partywagon112/EEE20003-Integrated-Lab-Equipment/README.md

# EEE20003-Integrated-Lab-Equipment
A compilation of the designs used in the SMT revision of the laboratory equpiment designed for EEE20003.

Designed by Jordan Boekel, Ben Gregg, and Patrick Curtain.
