partywagon112/EEE20003-Integrated-Lab-Equipment/Management/Minutes/Meeting minutes week 2.docx

# Meeting minutes

Laid out goals for the project

Discussed with project supervisor

Current plans

- Power supply implementation (5V in, 3.3V out)
- Prioritize Traffic lights, Clock, Switch module
- If possible, implement other modules
- Optimize for lower costs, manufacturability – Surface mount, common parts, built in China
