partywagon112/EEE20003-Integrated-Lab-Equipment/Management/Minutes/Meeting Minutes Week 4.docx

Submitted proposal.

Not coding

Serial buffers for low speed outputs.

Hardware debouncing is a bit crap, very large.

Patrick suggests a second micro for debouncing if necessary.

Considered the use of I2C port expanders to handle numerous inputs on a single microprocessor.
