partywagon112/EEE20003-Integrated-Lab-Equipment/PCB/Fabrication/REV0-1/bom.xls

Comment | Description | Designator | Footprint | LibRef | Quantity
1k |  | R7, R8, R9, R10, R11, R12, R13, R18, R27, R30, R31, R34, R39, R40, R41, R42, R43, R44, R45, R46, R55, R56, R57, R58, R59, R60, R61, R62, R68, R71 | 805 | RC0805FR071KL | 30
1uF |  | C1, C3, C7, C8 | 805 | GCM21BR71A105KA37L | 4
4.7uF |  | C2 | 805 | GCM21BR61A475KA37L | 1
5.1k |  | R20, R22 | 805 | RC0805FR075K1L | 2
10k |  | R1, R2, R3, R4, R5, R6, R14, R15, R16, R17, R35, R36, R37, R38, R47, R48, R49, R50, R51, R52, R53, R54 | 805 | RC0805FR0710KL | 22
10nF |  | C9 | 805 | GCM21BR71H103KA37L | 1
22pF |  | C4, C5 | 805 | GCM21B5C1H220JA37L | 2
100nF |  | C6 | 805 | GCM21BR71E104KA37L | 1
100R |  | R21, R69, R70, R72, R73, R74, R75, R76 | 805 | RC0805FR07100RL | 8
200R |  | R19 | 805 | RC0805FR07200RL | 1
330R |  | R23, R24, R25, R26, R67 | 805 | RC0805FR07330RL | 5
680R |  | R28, R29, R32, R33, R63, R64, R65, R66 | 805 | RC0805FR07680RL | 8
LED | Red LED Indication - Discrete 1.75V 0805 (2012 Metric) | D45 | 0805 LED | SML-210LTT86 | 1
Red | Green LED Indication - Discrete 1.75V 0805 (2012 Metric) | D11, D12, D15, D16 | 0805 LED | SML-210FTT86 | 4
Red | Orange LED Indication - Discrete 1.75V 0805 (2012 Metric) | D10, D14 | 0805 LED | SML-211DTT86 | 2
Red | Red LED Indication - Discrete 1.75V 0805 (2012 Metric) | ACTIVE1, D1, D2, D3, D4, D5, D6, D7, D9, D13, D17, D18, D19, D20, D21, D22, D23, D24, D25, D26, D27, D28, D29, D30, D31, D32, D33, D34, D35, D36, D37, D38, D39, D40, D41, D42, D43, D44 | 0805 LED | SML-210LTT86 | 38
0ZCF0100AF2A | PTC RESET FUSE 60V 1A 292 | F1 | 2920 | 0ZCF0100AF2A | 1
 |  | X1 | Abracon HC-49/US | ABLS-16.000MHZ-B4-T | 1
ATMEGA 328P-AU | AVR AVR® ATmega Microcontroller IC 8-Bit 20MHz 32KB (16K x 16) FLASH 32-TQFP (7x7) | BRUCE SPRINGSTEEN1 | ATMEL TQFP-32 | ATMEGA 328P-AU | 1
2.54mm |  | FREQUENCY1, POWER 1, POWER 2 | Header 2x2 | Header 2x2 | 3
2.54mm |  | ICSP1 | Header 2x3 | Header 2x3 | 1
2.54mm |  | P1, STEPPER INPUT1, TRAFFIC INPUT1, TRAFFIC OUTPUT1 | Header 2x4 | Header 2x4 | 4
Header 2x8 |  | FUN BUTTON OUTPUT1, FUN BUTTON OUTPUT2, LIGHTS INPUT1 | Header 2x8 | Header 2x8 | 3
SSD1306 | AU 0.91" IIC I2C OLED LCD Display Module 128x32 for Arduino PIC SSD1306 3.3V~5V | U3 | IIC 128x32 OLED | SSD1306 | 1
SS0823 | SPDT Switch | K16 | Jaycar 2.54 SPDT Slide | SS0823 | 1
MCP23017 | IC I/O EXPANDER I2C 16B 28SOIC | TRAFFIC EXPANDER1, U6 | Microchip 28-SOIC | MCP23017 | 2
RS3236-3.3 | Low Power, Low Dropout, 500mA RF LinearRegulators | U4 | Runic SOT-23-5 | RS3236-3.3 | 1
S16C03-8TR | PD 300W VWM 3.3VCJ 425PFPACKAGE | U2, U5, U8 | SMC 16-SOIC | S16C03-8TR | 3
SN74HC540DWR | IC BUFFER INVERT 6V 20SOIC | U1, U7 | TI 20-SOIC | SN74HC540DWR | 2
USB4085-GF-A | USB - C (Type - C) USB 2.0 Receptacle Connector 16 Position Through Hole, Right Angle | USB1 | USB4085-GF-A | USB4085-GF-A | 1
TS-1187A-C-D-B | TACTILE SWITCHES SPST 5.10MM X 5.10MM 0.80MM SMD ROHS | K1, K2, K3, K4, K5, K6, K7, K8, K9, K10, K11, K12, K13, K14, K15 | XKB SW-4.5 | TS-1187A-C-D-B | 15
