partywagon112/EEE20003-Integrated-Lab-Equipment/PCB/Prints/Bottom Layer-1.png

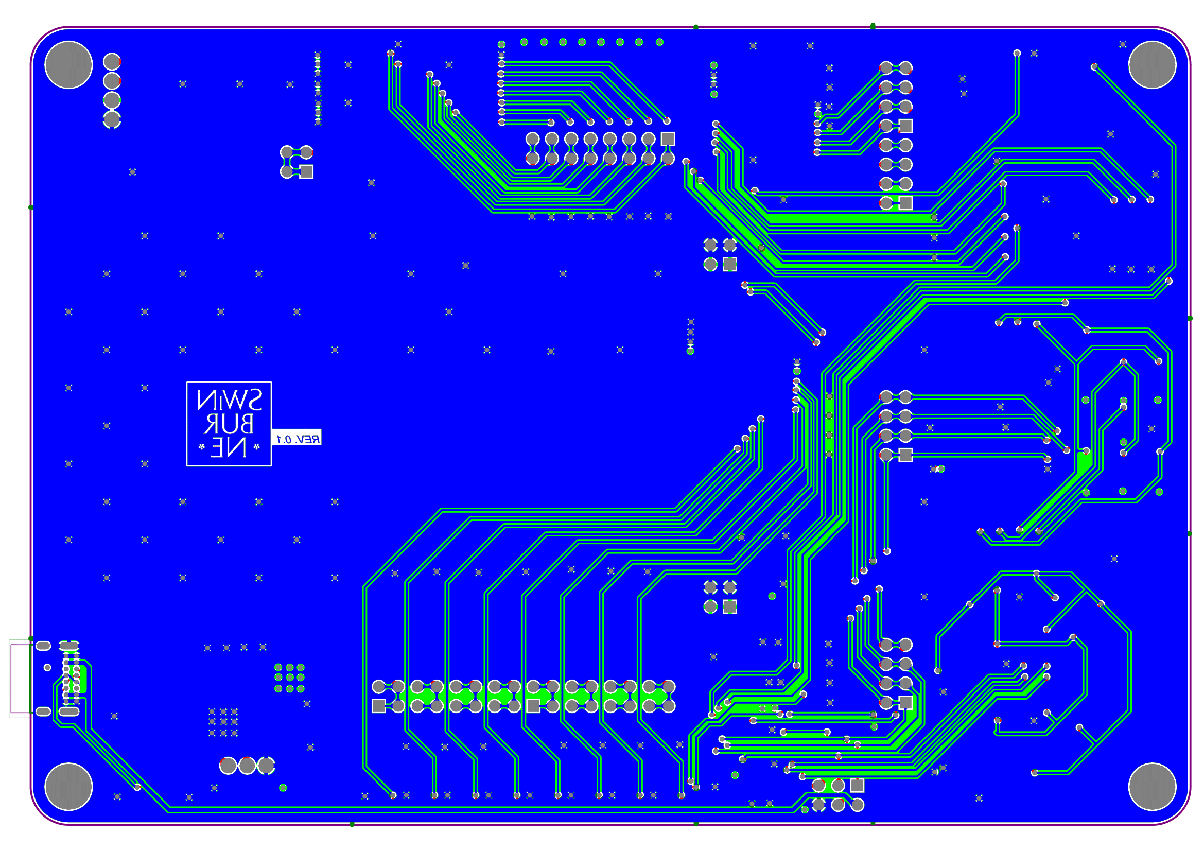
PCB/Prints/Bottom Layer-1.png
