partywagon112/EEE20003-Integrated-Lab-Equipment/PCB/Prints/EEE20001 Lab Equipment-04.png

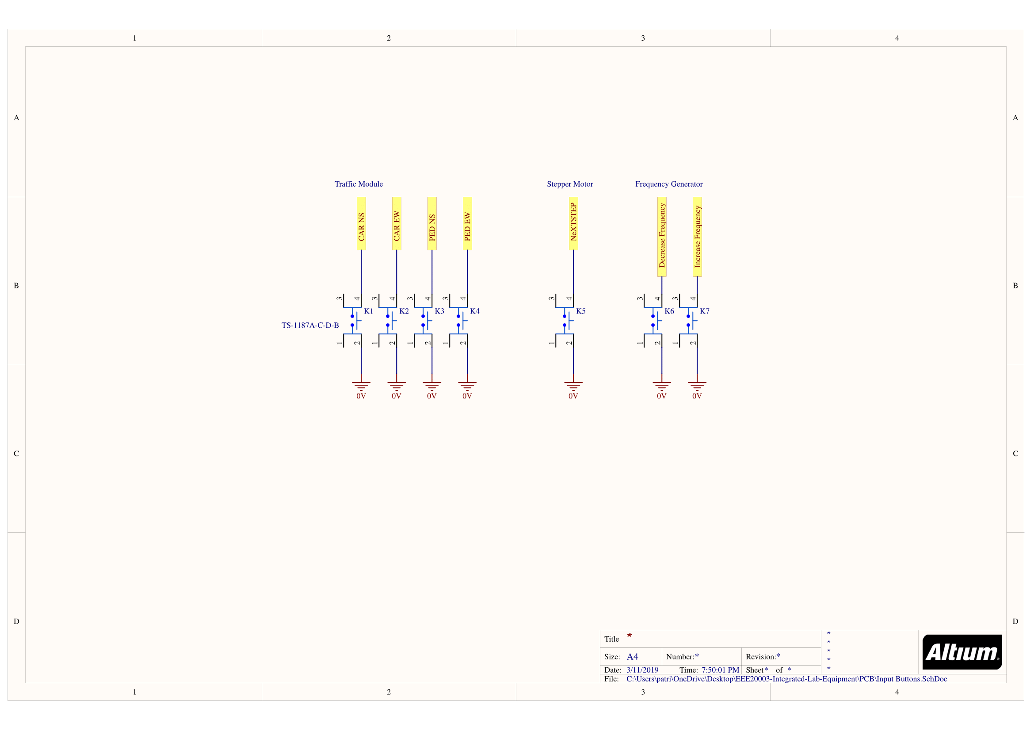
PCB/Prints/EEE20001 Lab Equipment-04.png
