partywagon112/EEE20003-Integrated-Lab-Equipment/PCB/Prints/EEE20001 Lab Equipment.pdf

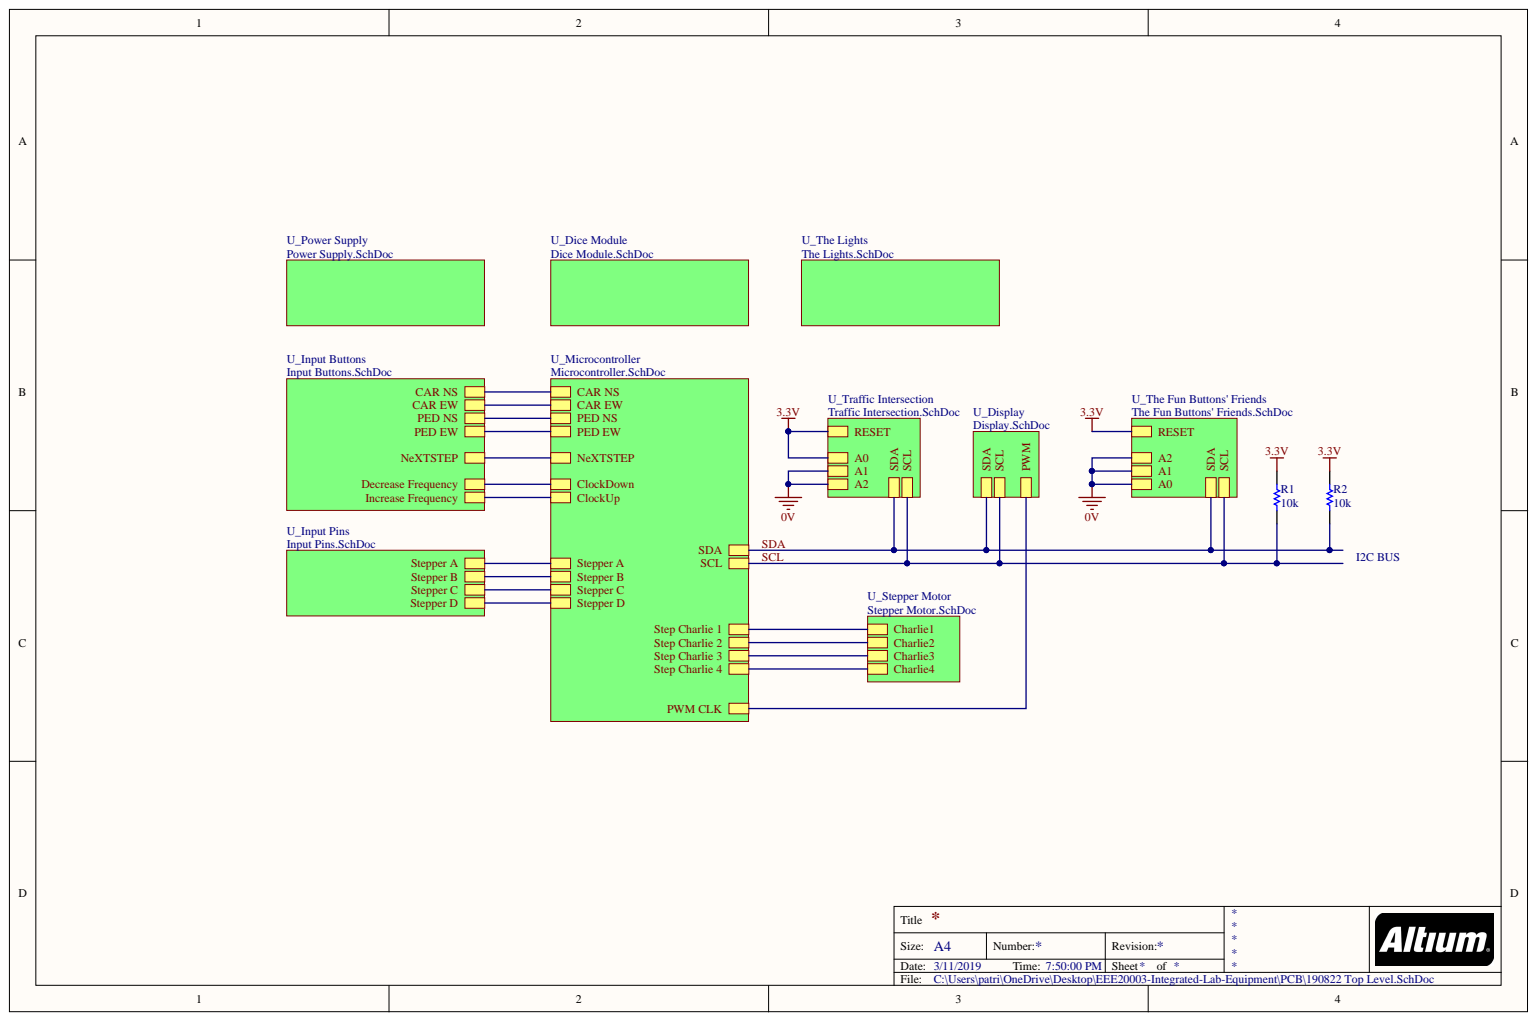
[picture p13: page 1]

RESET SDA

U_Stepper Motor Stepper Motor.SchDoc

* Title | ****

Size: A4 | Number: * | Revision: *
Date: 3/11/2019 Time: 7:50:00 PM | | Sheet * of

C:\Users\patri\OneDrive\Desktop\EEE20003-Integrated-Lab-Equipment\PCB\190822 Top Level.SchDoc

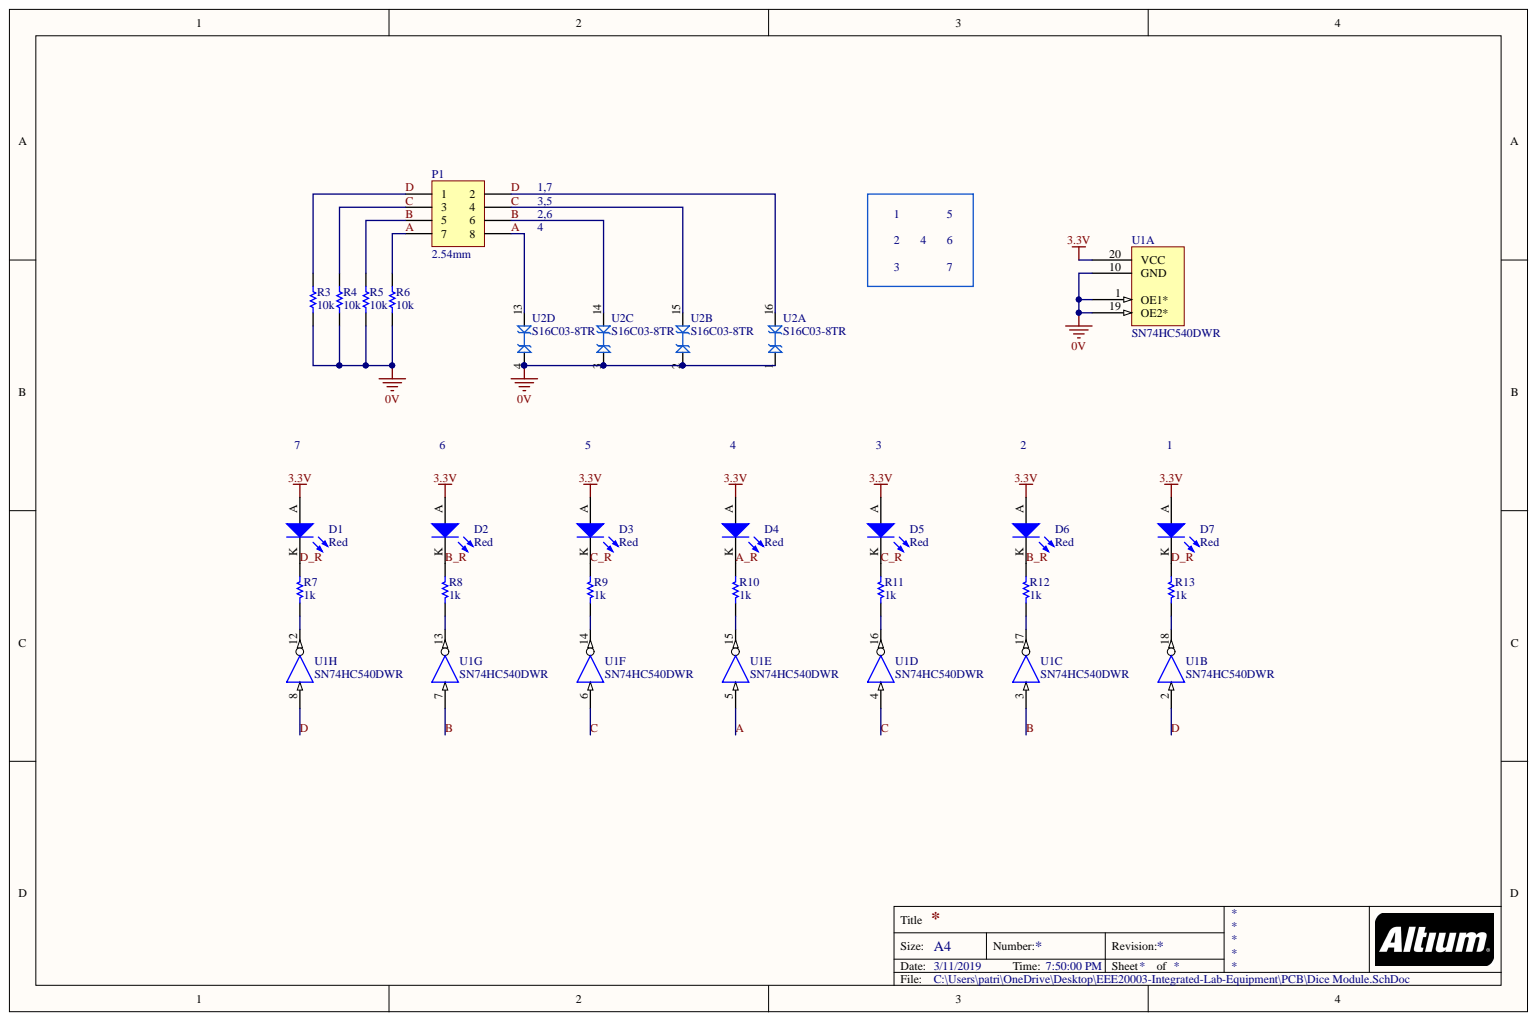
[picture p14: page 2]

B | B 2,6
A | A 4

* Title | * * * * *

Size: A4 | Number: * | Revision: *

C:\Users\patri\OneDrive\Desktop\EEE20003-Integrated-Lab-Equipment\PCB\Dice Module.SchDoc

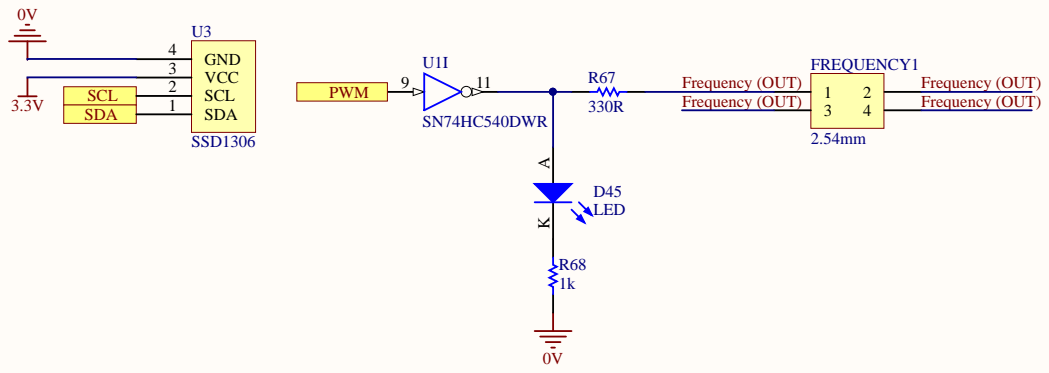
[picture p15: page 3]

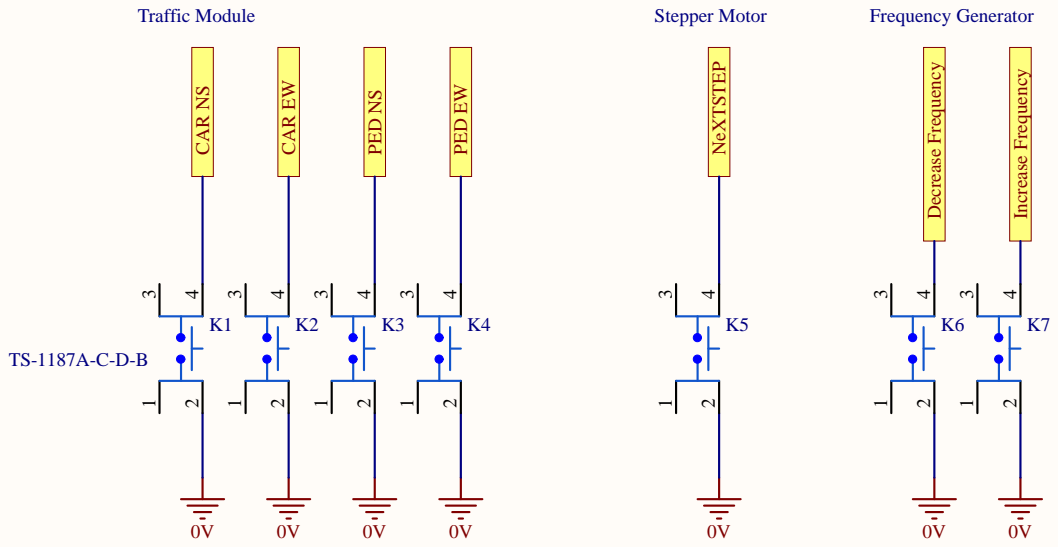
[picture p16: page 4]

* Title | ****

Size: A4 | Number: * | Revision: *

C:\Users\patri\OneDrive\Desktop\EEE20003-Integrated-Lab-Equipment\PCB\Input Buttons.SchDoc

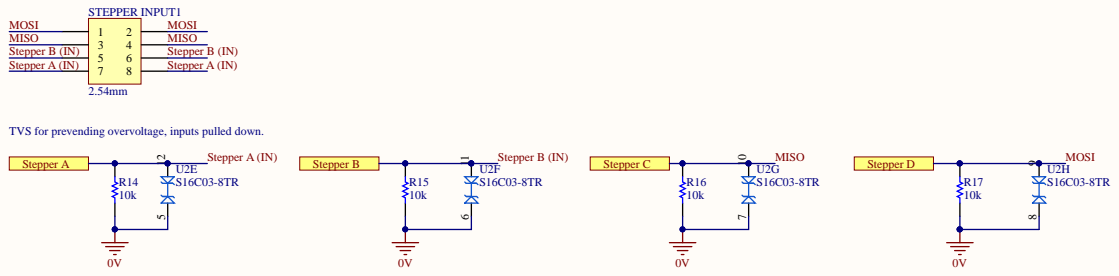
[picture p17: page 5]

TVS for prevending overvoltage, inputs pulled down.

* Title | * *

Size: A4 | Number: * | Revision: *

C:\Users\patri\OneDrive\Desktop\EEE20003-Integrated-Lab-Equipment\PCB\Input Pins.SchDoc

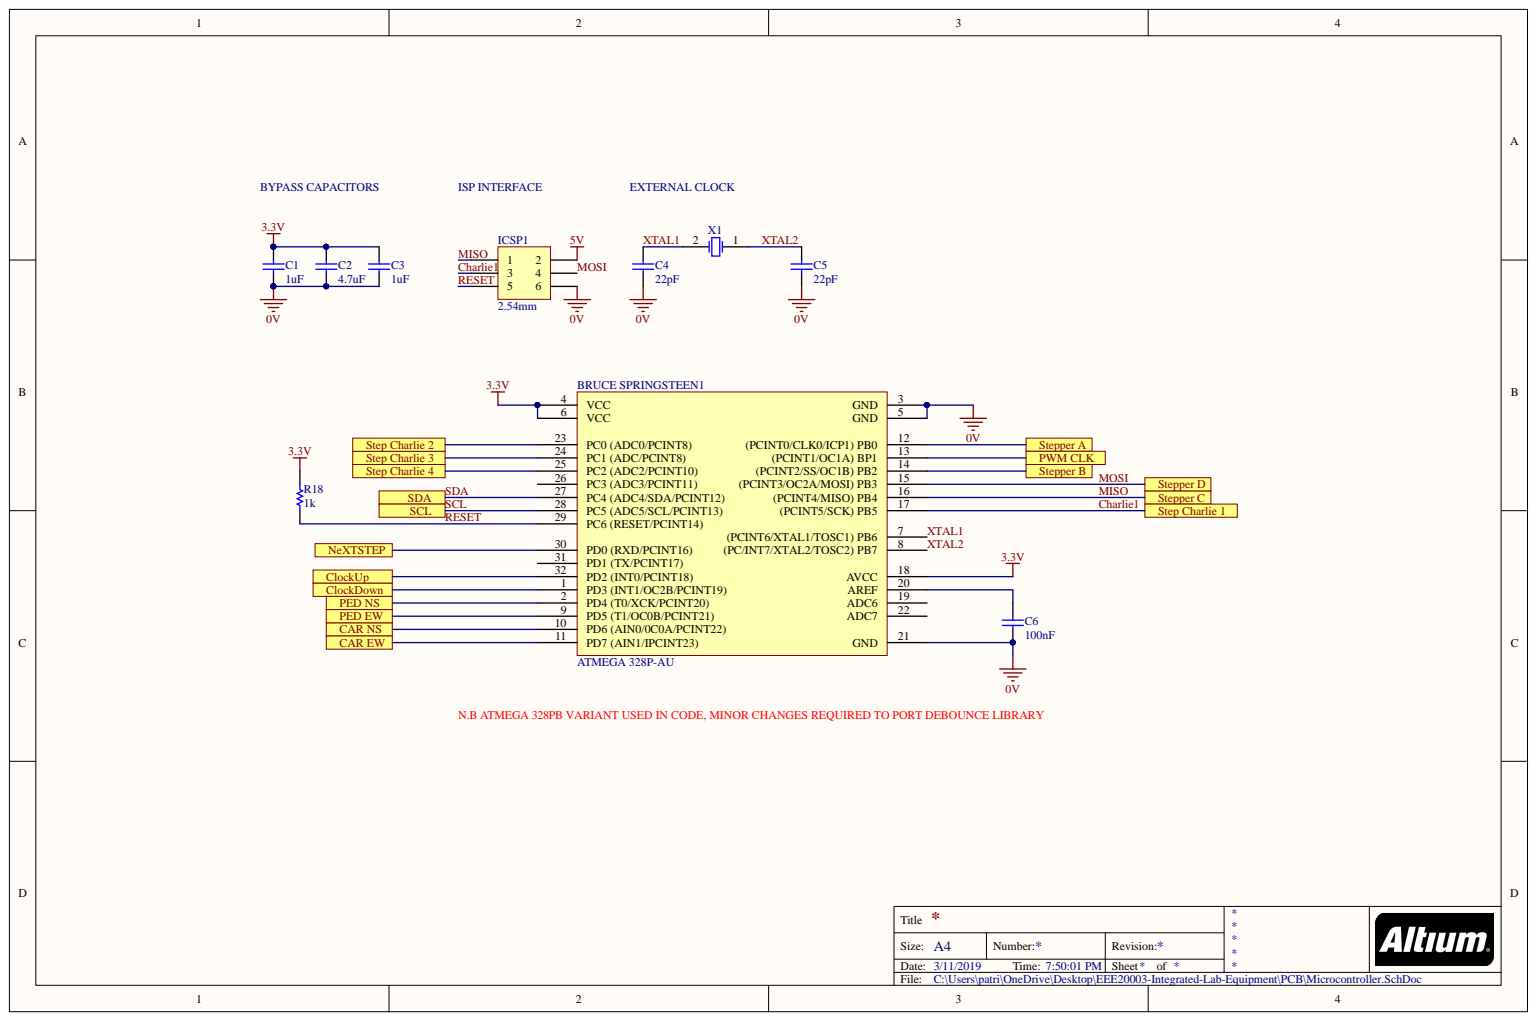
[picture p18: page 6]

SCL | PC5 (ADC5/SCL/PCINT13) 28 | Charlie1

SCL | Step Charlie 1

N.B ATMEGA 328PB VARIANT USED IN CODE, MINOR CHANGES REQUIRED TO PORT DEBOUNCE LIBRARY

* Title | * *

Size: A4 | Number: * | Revision: *

C:\Users\patri\OneDrive\Desktop\EEE20003-Integrated-Lab-Equipment\PCB\Microcontroller.SchDoc

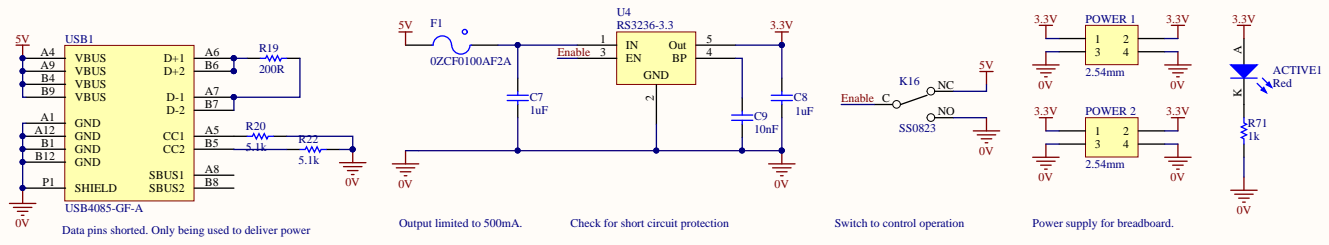
[picture p19: page 7]

Data pins shorted. Only being used to deliver power

* Title | ****

Size: A4 | Number: * | Revision: *

C:\Users\patri\OneDrive\Desktop\EEE20003-Integrated-Lab-Equipment\PCB\Power Supply.SchDoc

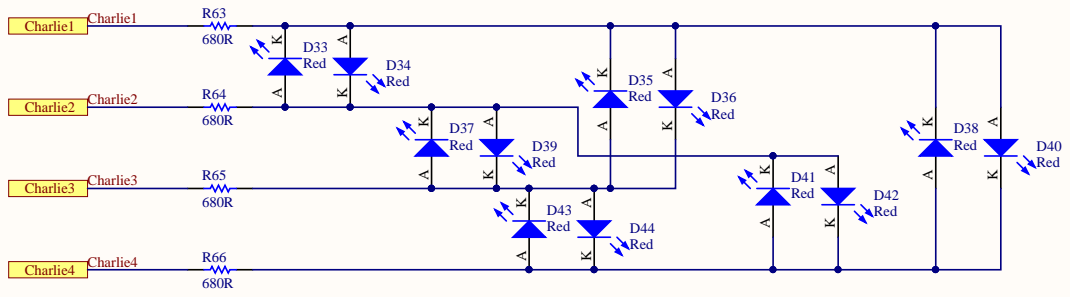
[picture p20: page 8]

* Title | ****

Size: A4 | Number: * | Revision: *

C:\Users\patri\OneDrive\Desktop\EEE20003-Integrated-Lab-Equipment\PCB\Stepper Motor.SchDoc

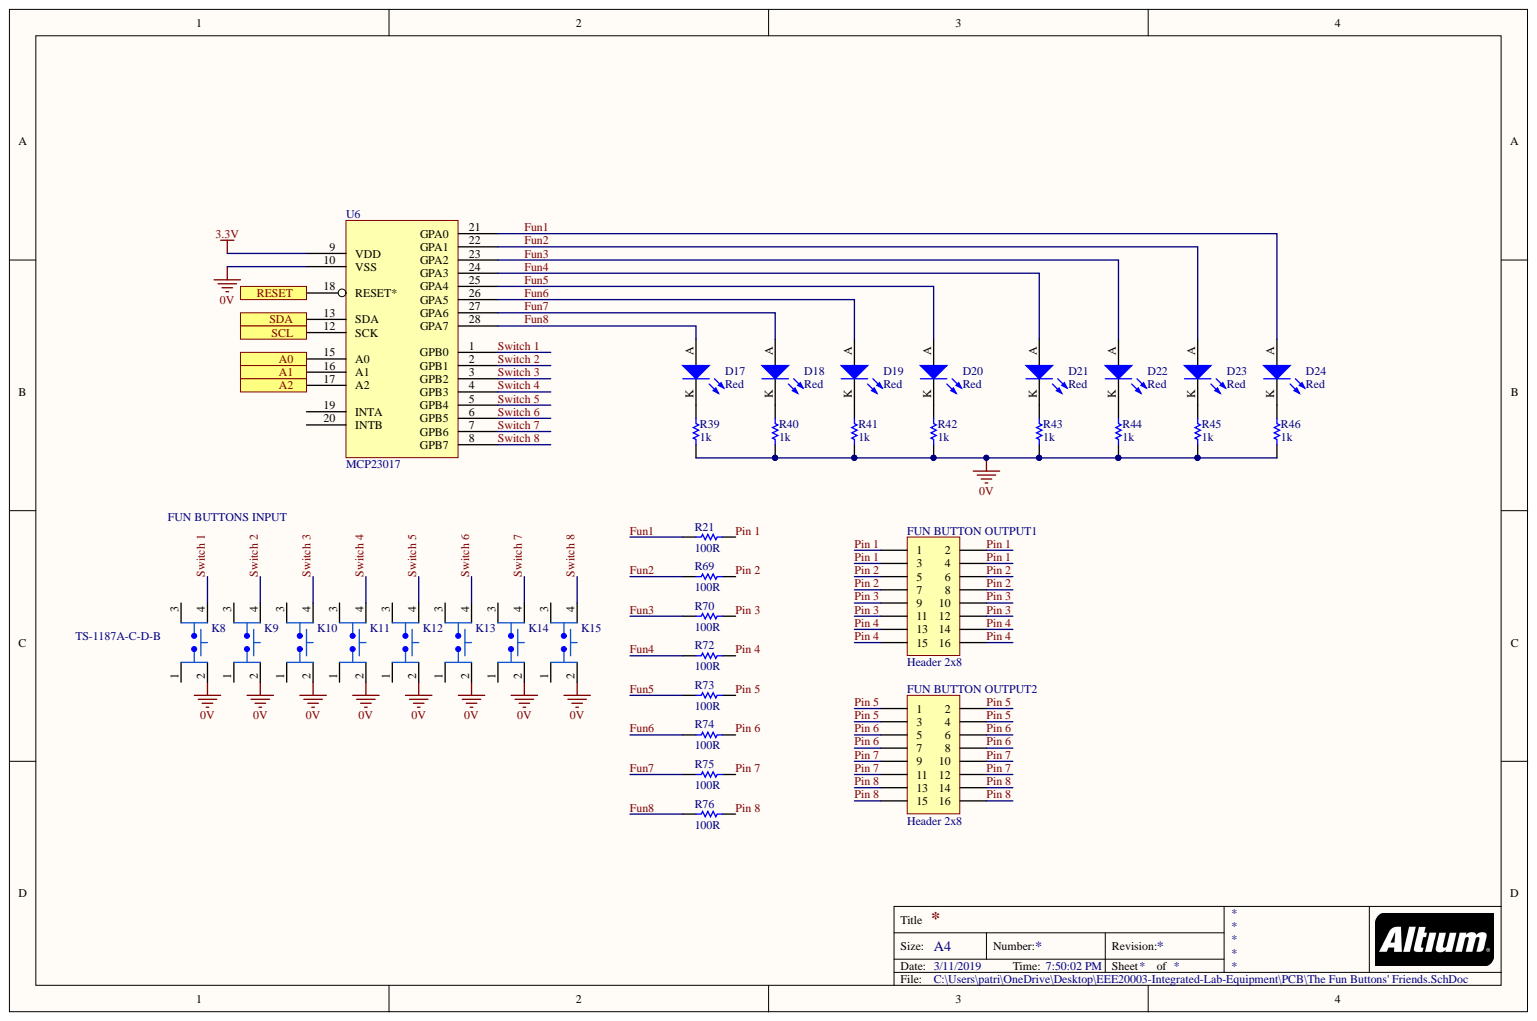
[picture p21: page 9]

* Title | * *

Size: A4 | Number: * | Revision: *

C:\Users\patri\OneDrive\Desktop\EEE20003-Integrated-Lab-Equipment\PCB\The Fun Buttons' Friends.SchDoc

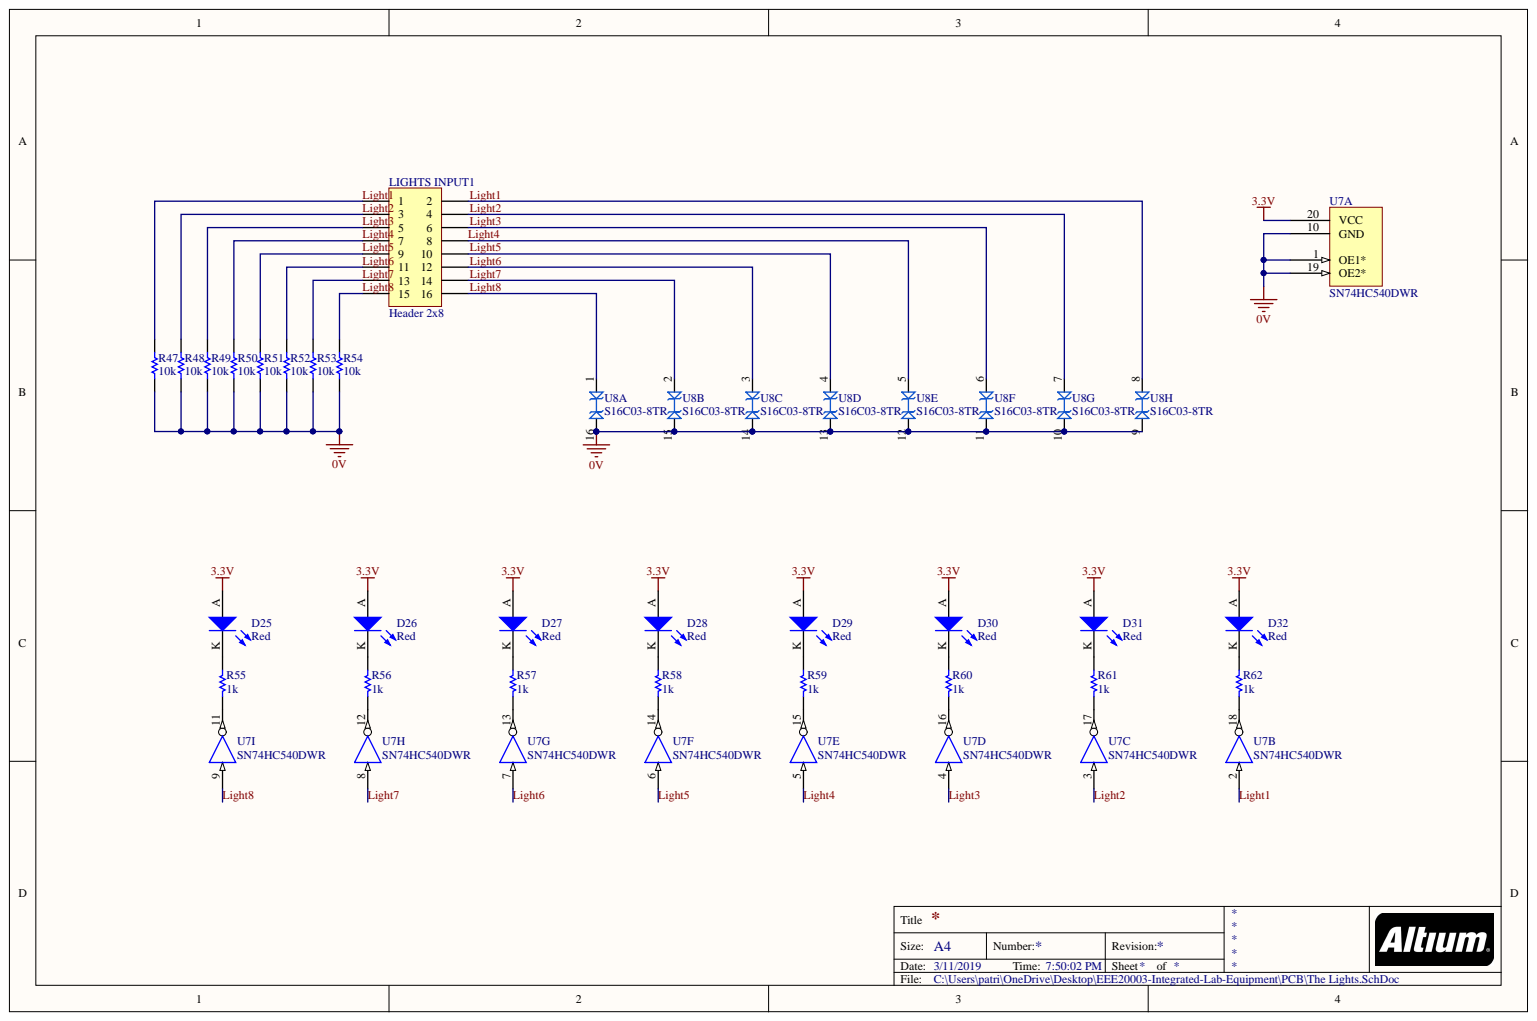
[picture p22: page 10]

Light2 | Light2
Light3 | Light3
Light4 | Light4
Light5 | Light5
Light6 | Light6
Light7 | Light7
Light8 | Light8

GND 10

OE1* 1
OE2* 19

* Title | * *

Size: A4 | Number: * | Revision: *

C:\Users\patri\OneDrive\Desktop\EEE20003-Integrated-Lab-Equipment\PCB\The Lights.SchDoc

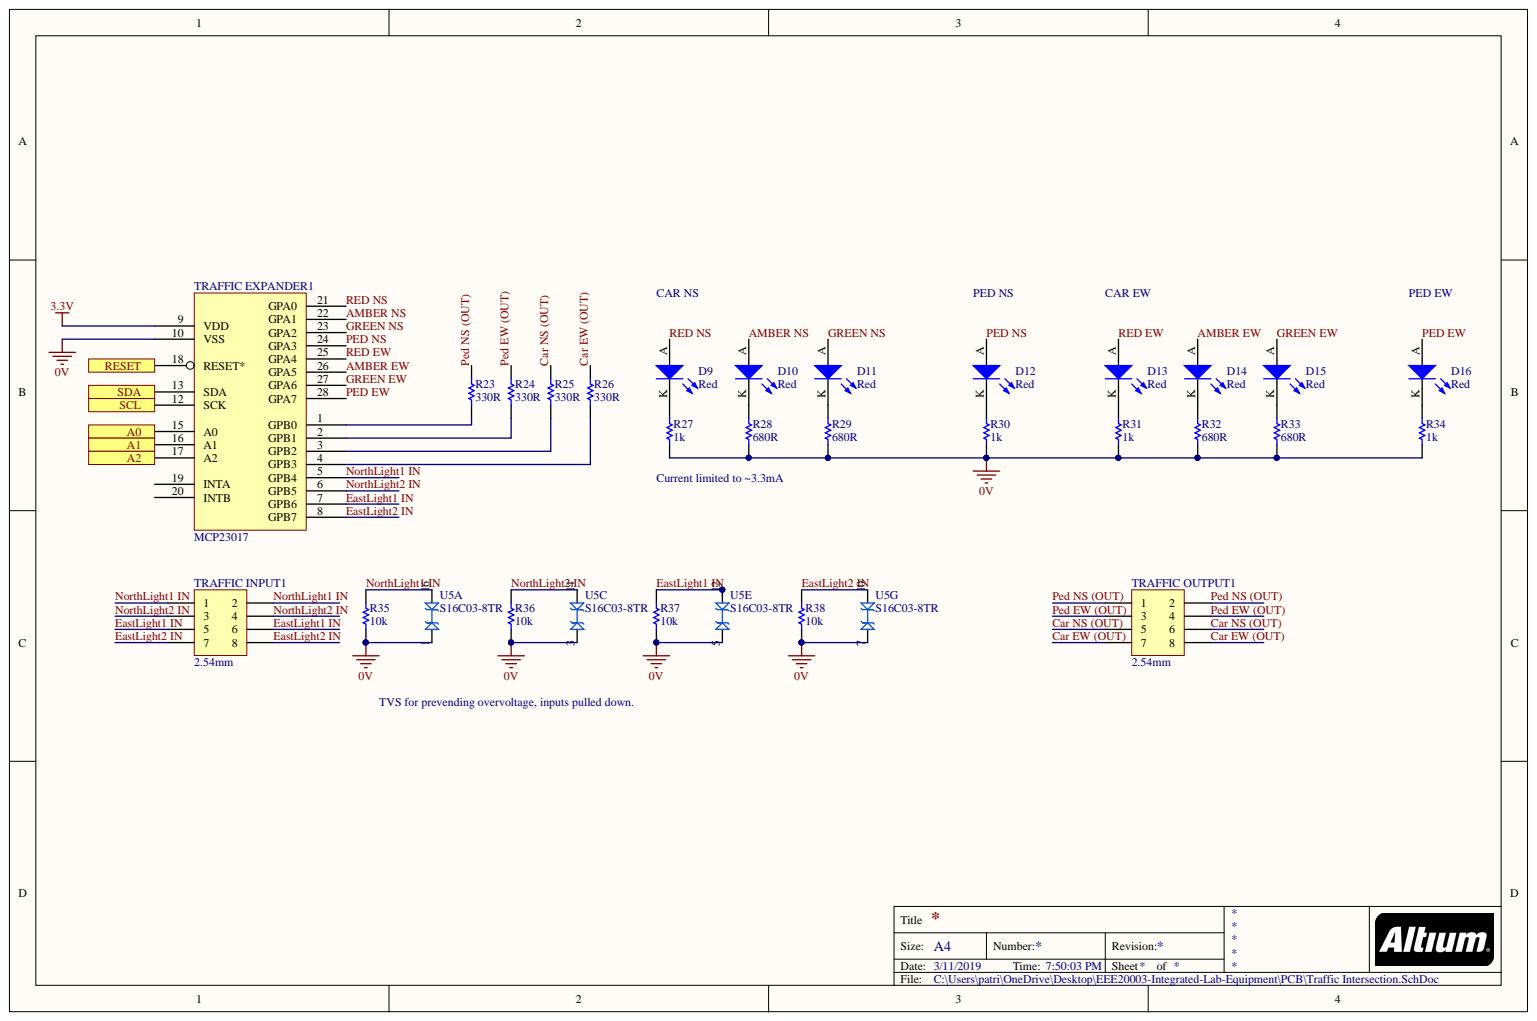
[picture p23: page 11]

TVS for prevending overvoltage, inputs pulled down.

* Title | ****

Size: A4 | Number: * | Revision: *

C:\Users\patri\OneDrive\Desktop\EEE20003-Integrated-Lab-Equipment\PCB\Traffic Intersection.SchDoc
