partywagon112/EEE20003-Integrated-Lab-Equipment/PCB/Prints/Bottom Layer.pdf

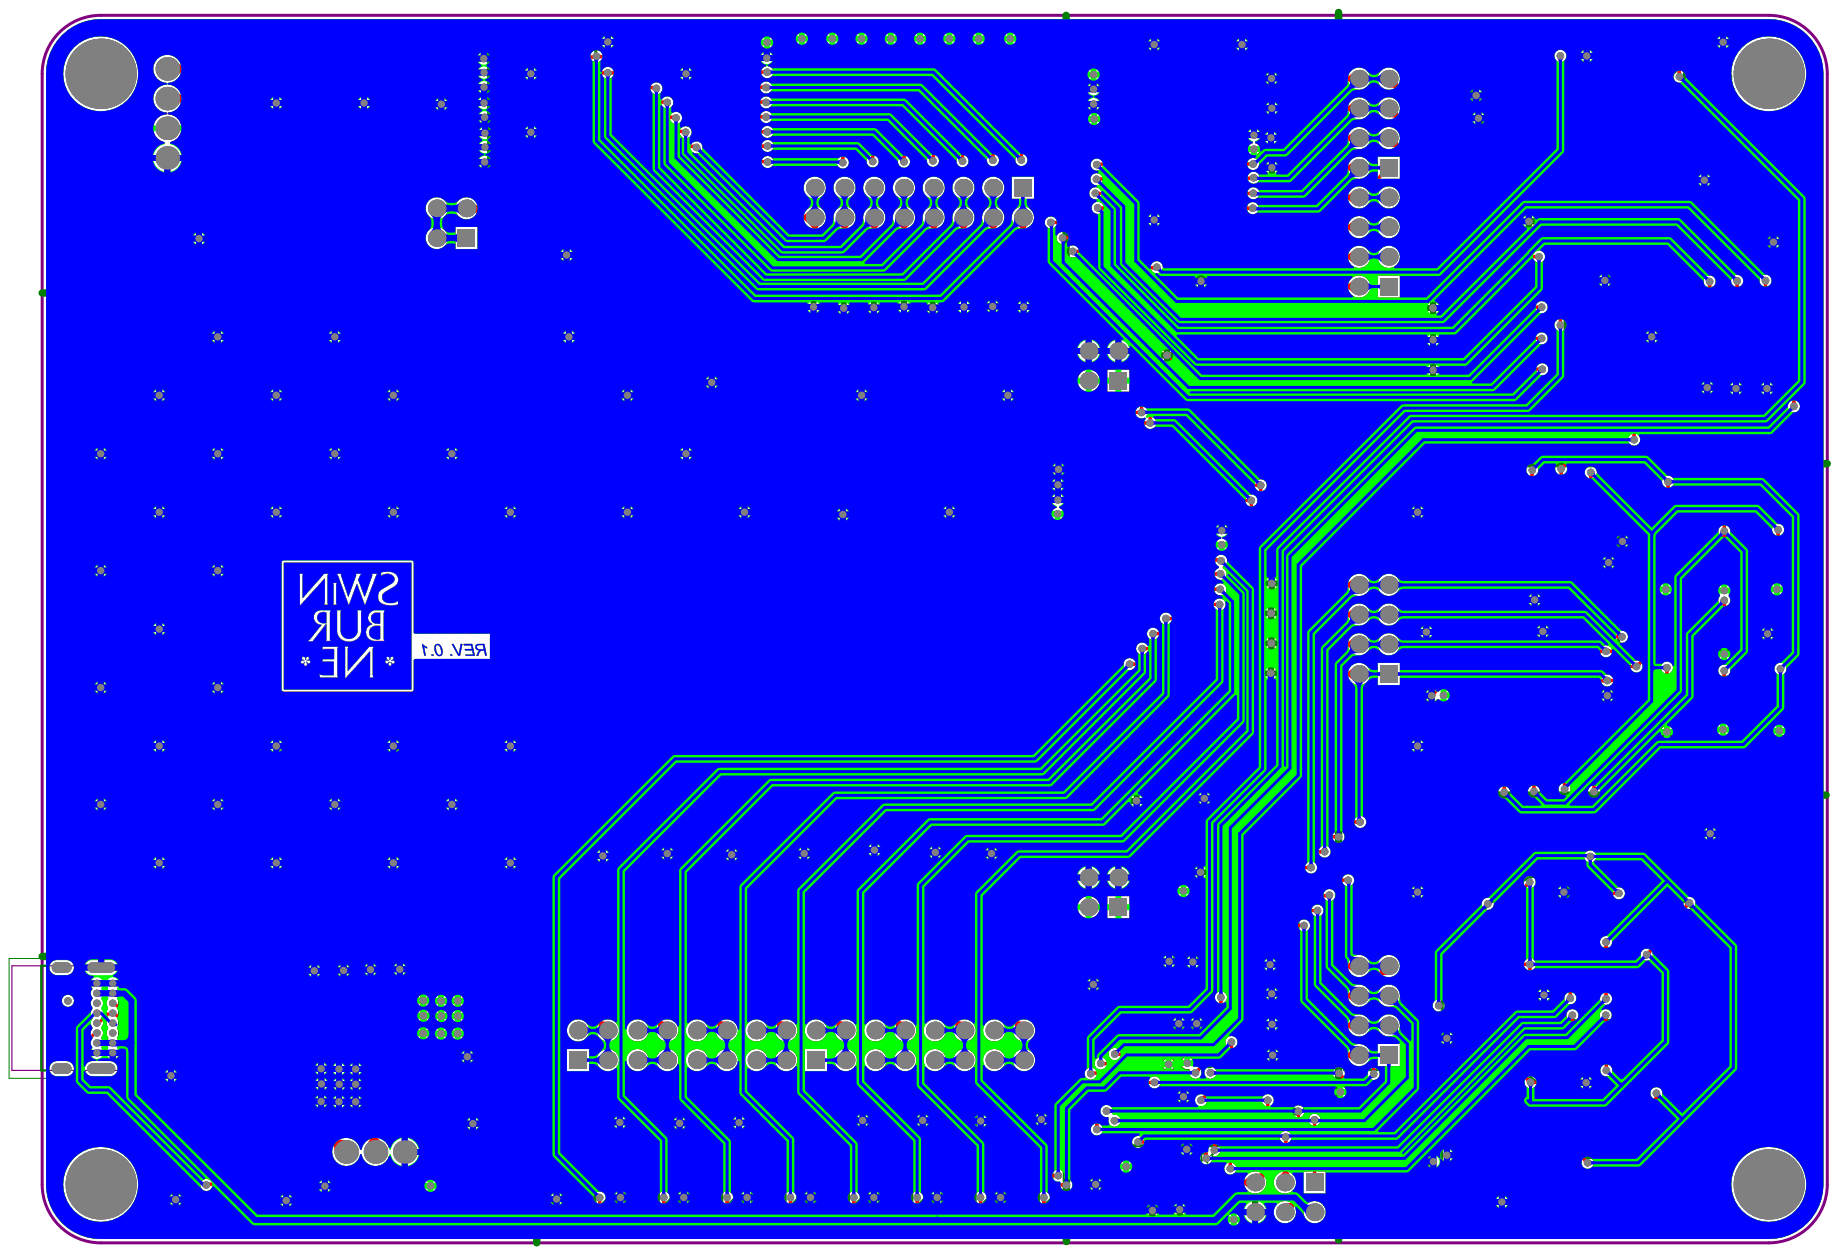
[picture p24: page 1]
