partywagon112/EEE20003-Integrated-Lab-Equipment/PCB/Prints/Top Layer.pdf

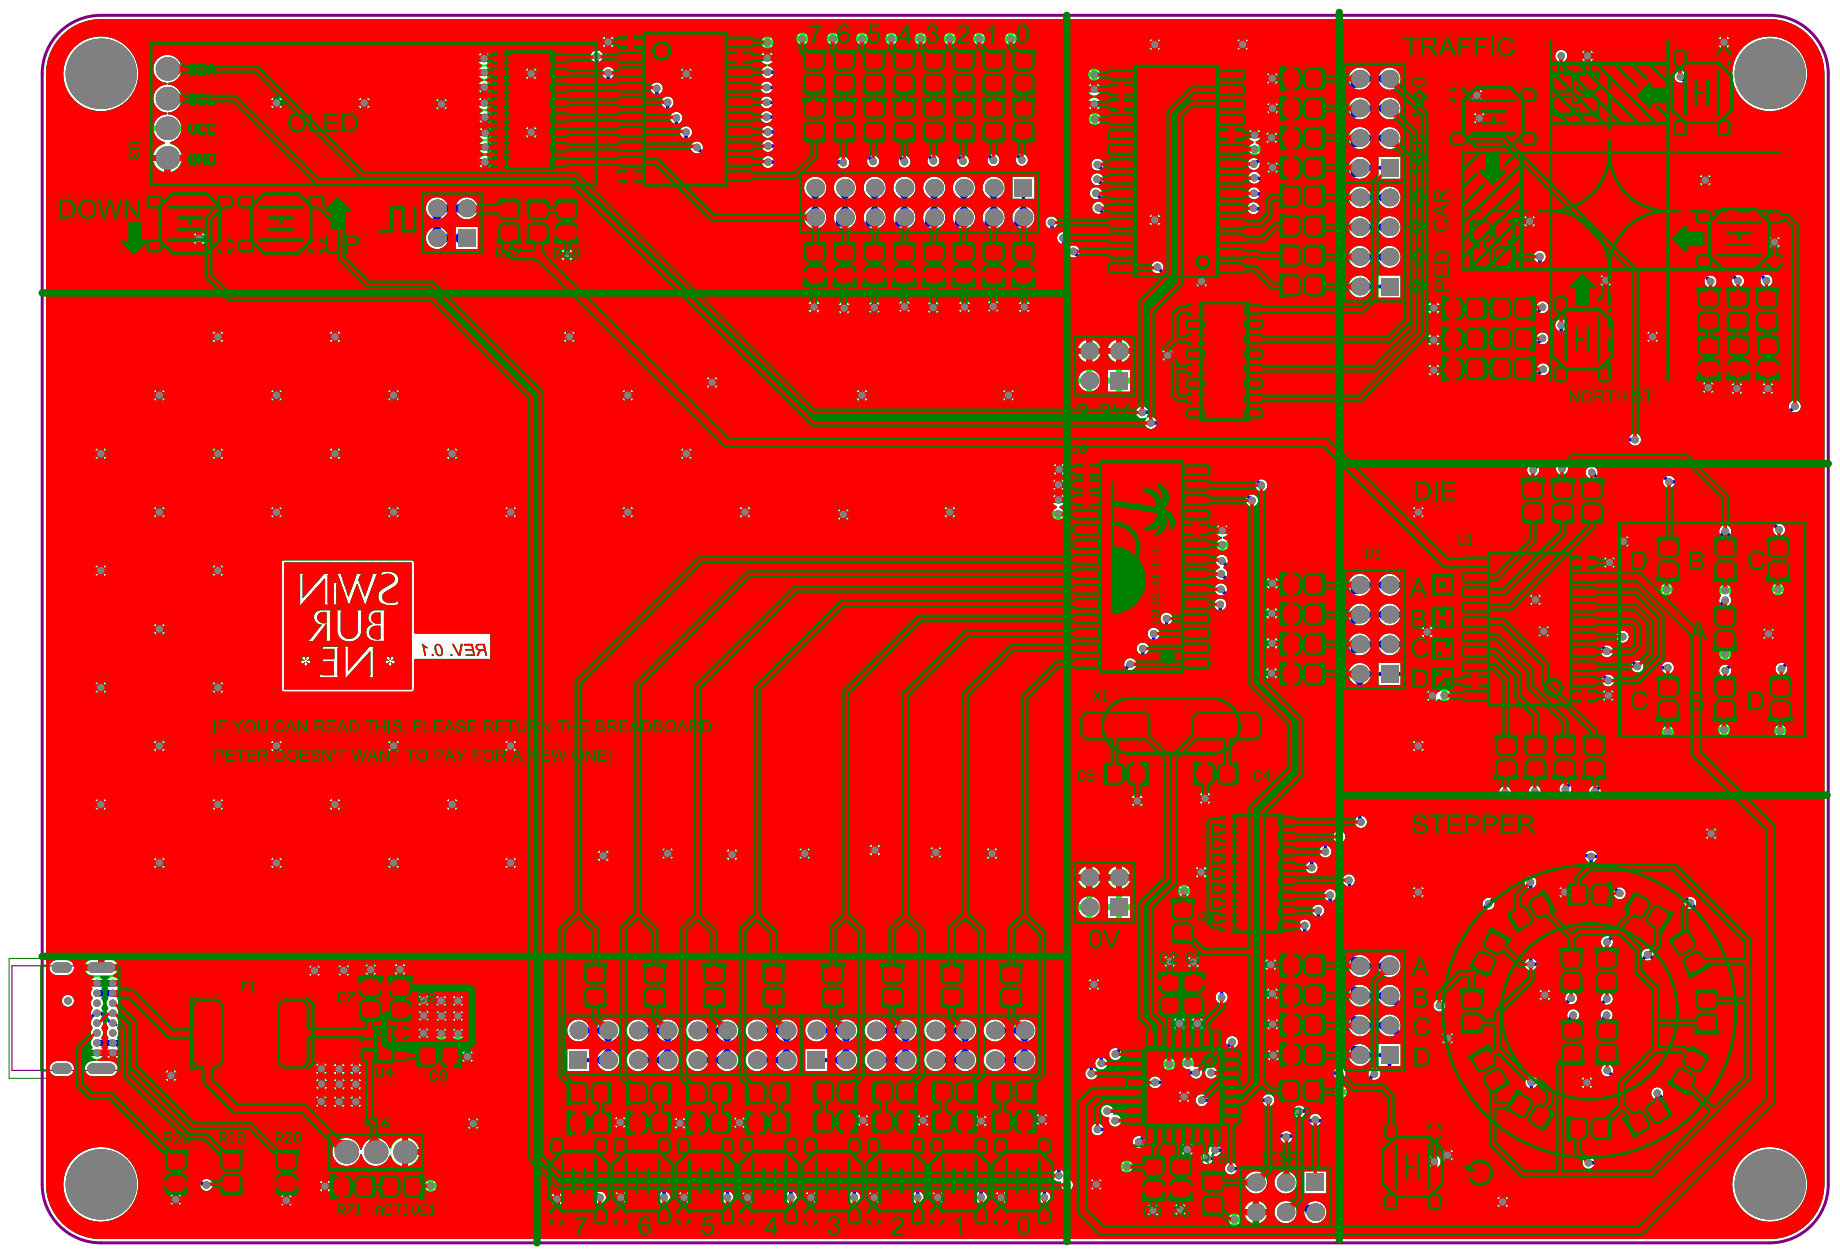
[picture p25: page 1]
