partywagon112/EEE20003-Integrated-Lab-Equipment/(list of files, drawings)

Other design files:
PCB/190822 Top Level.SchDoc
PCB/Dice Module.SchDoc
PCB/Display.SchDoc
PCB/EEE20001 Lab Equipment.PrjPcb
PCB/Input Buttons.SchDoc
PCB/Input Pins.SchDoc
PCB/Integrated Library/190822 Integrated DED Equipment.SCHLIB
PCB/Integrated Library/191015 Integrated DED Equipment.PcbLib
PCB/Microcontroller.SchDoc
PCB/Power Supply.SchDoc
PCB/Proposed/Power Supply (Alternate).SchDoc
PCB/Proposed/Power Supply (Switching).SchDoc
PCB/Stepper Motor.SchDoc
PCB/The Fun Buttons' Friends.SchDoc
PCB/The Lights.SchDoc
PCB/Traffic Intersection.SchDoc
