partywagon112/EEE20003-Integrated-Lab-Equipment/(commit log)

2019-10-24 Initlal Commit
    [190822 Integrated DED Equipment.SCHLIB, 190822 Top Level.SchDoc, 191015 Integrated DED Equipment.PcbLib, Dice Module.SchDoc, Display.SchDoc, EEE20001 Lab Equipment.PrjPcb, Gantt Chart.xlsx, Input Buttons.SchDoc]
2019-11-04 final commit
    [EEE20001 Lab Equipment.PrjPcb, The Lights.SchDoc]
